KarlK90/DZZY/cross_pattern.png

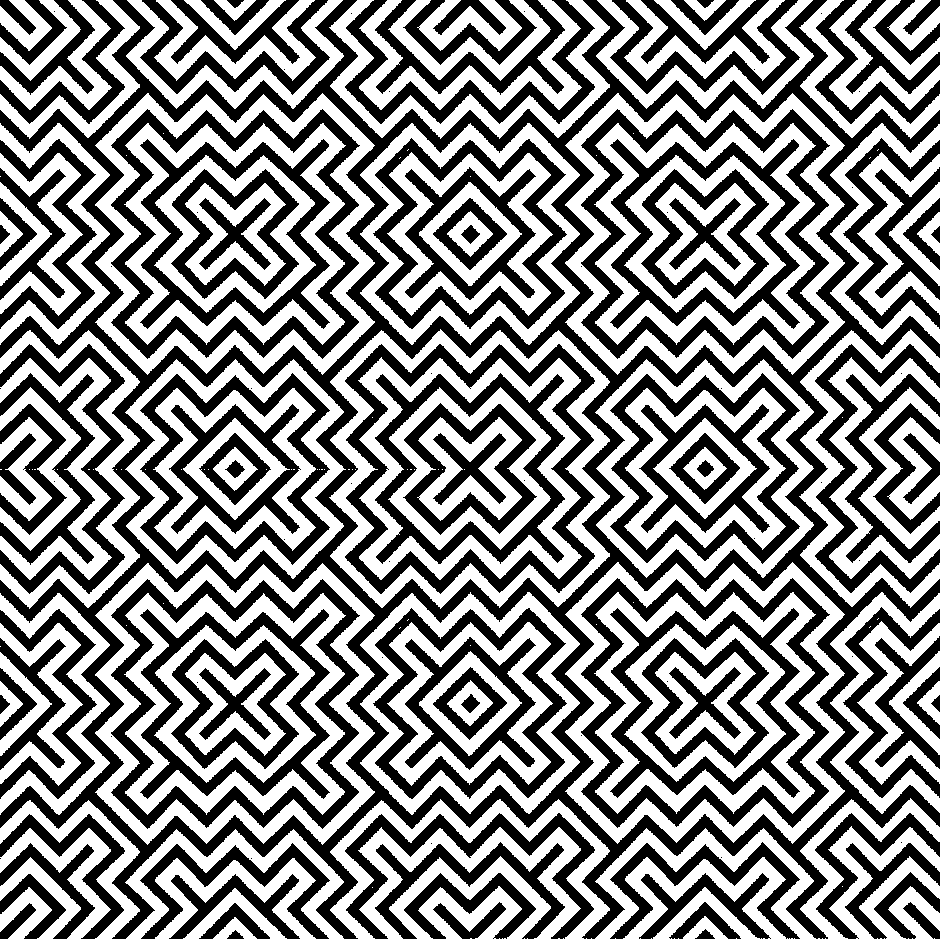
cross_pattern.png
