KarlK90/DZZY/dzzy.kicad_pcb

## KiCad design dzzy.kicad_pcb (2021-05-22)

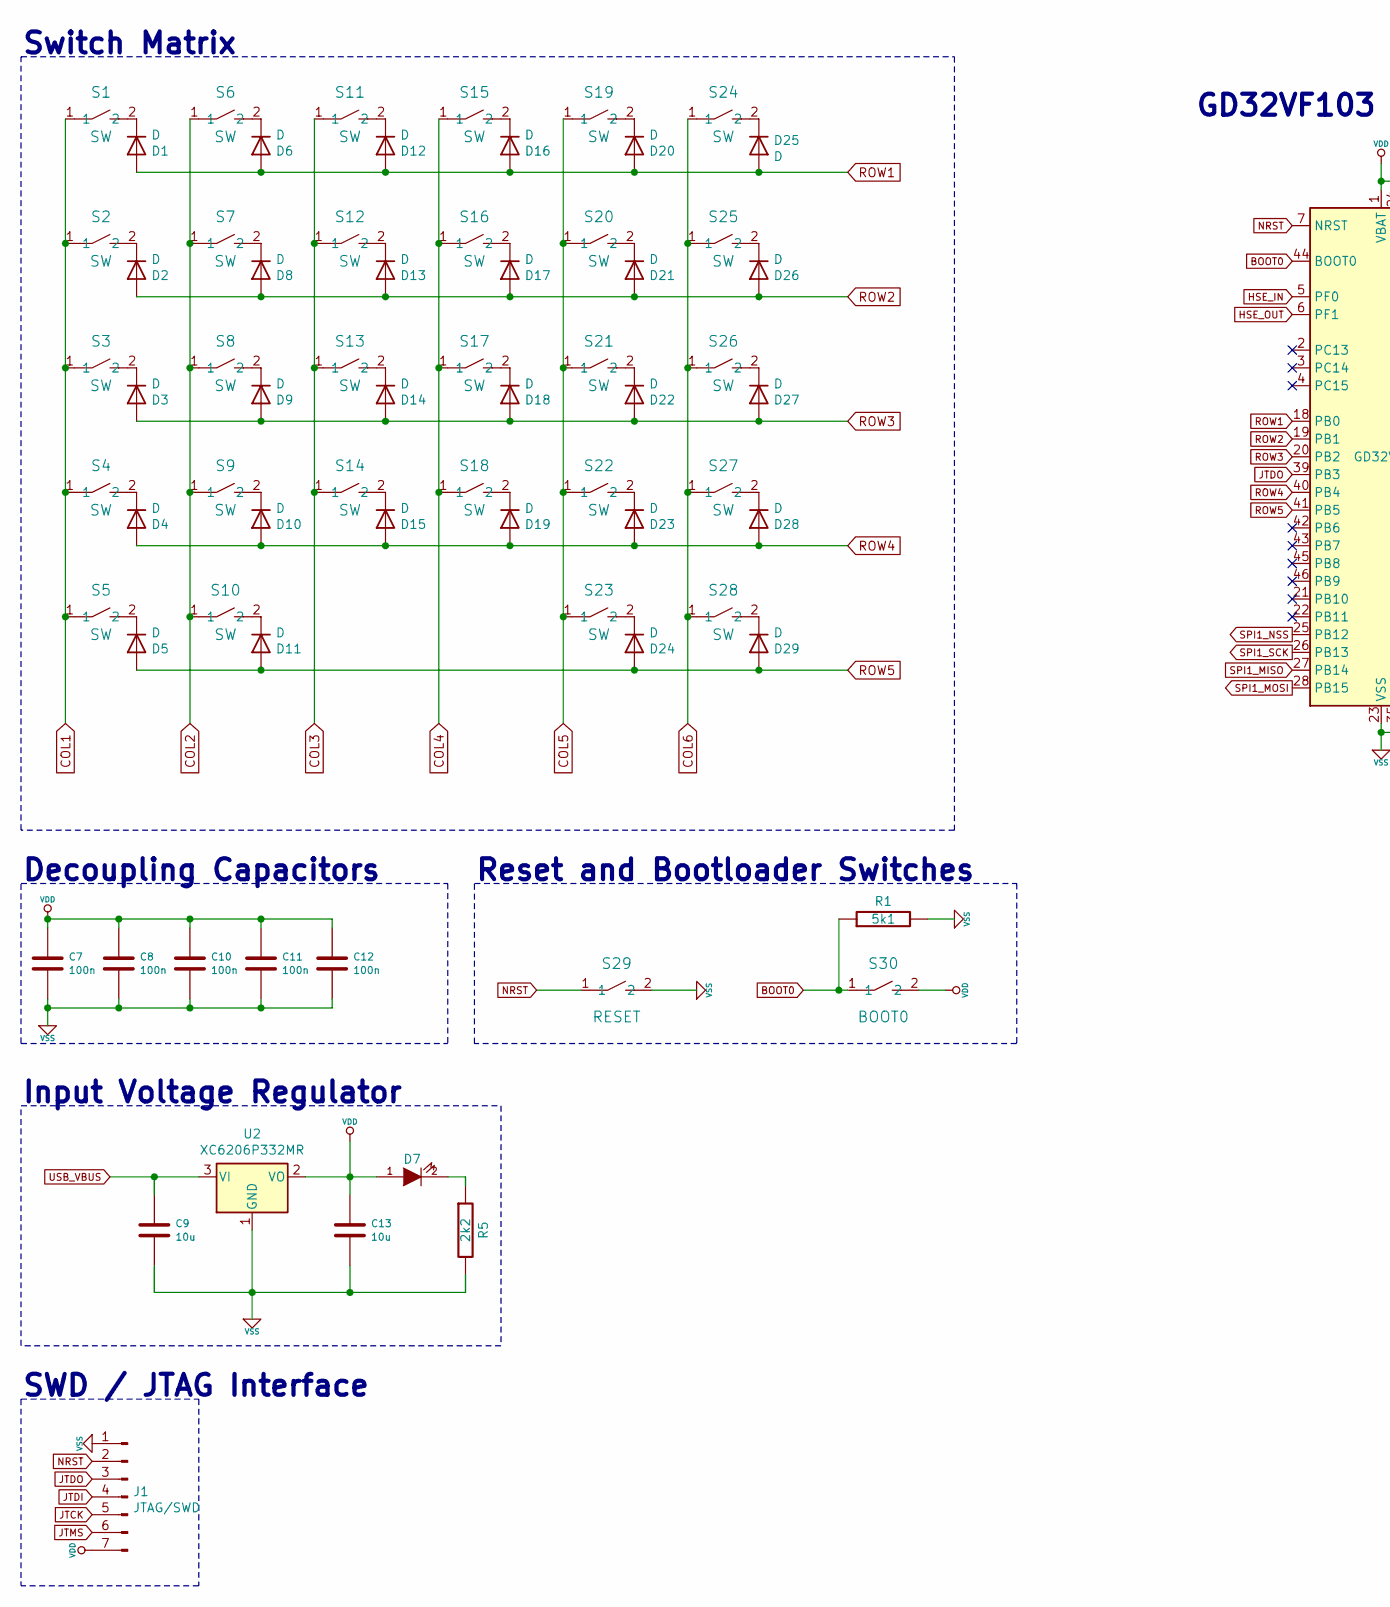
[picture p2: schematic dzzy.kicad_sch, part in row 1, column 1]

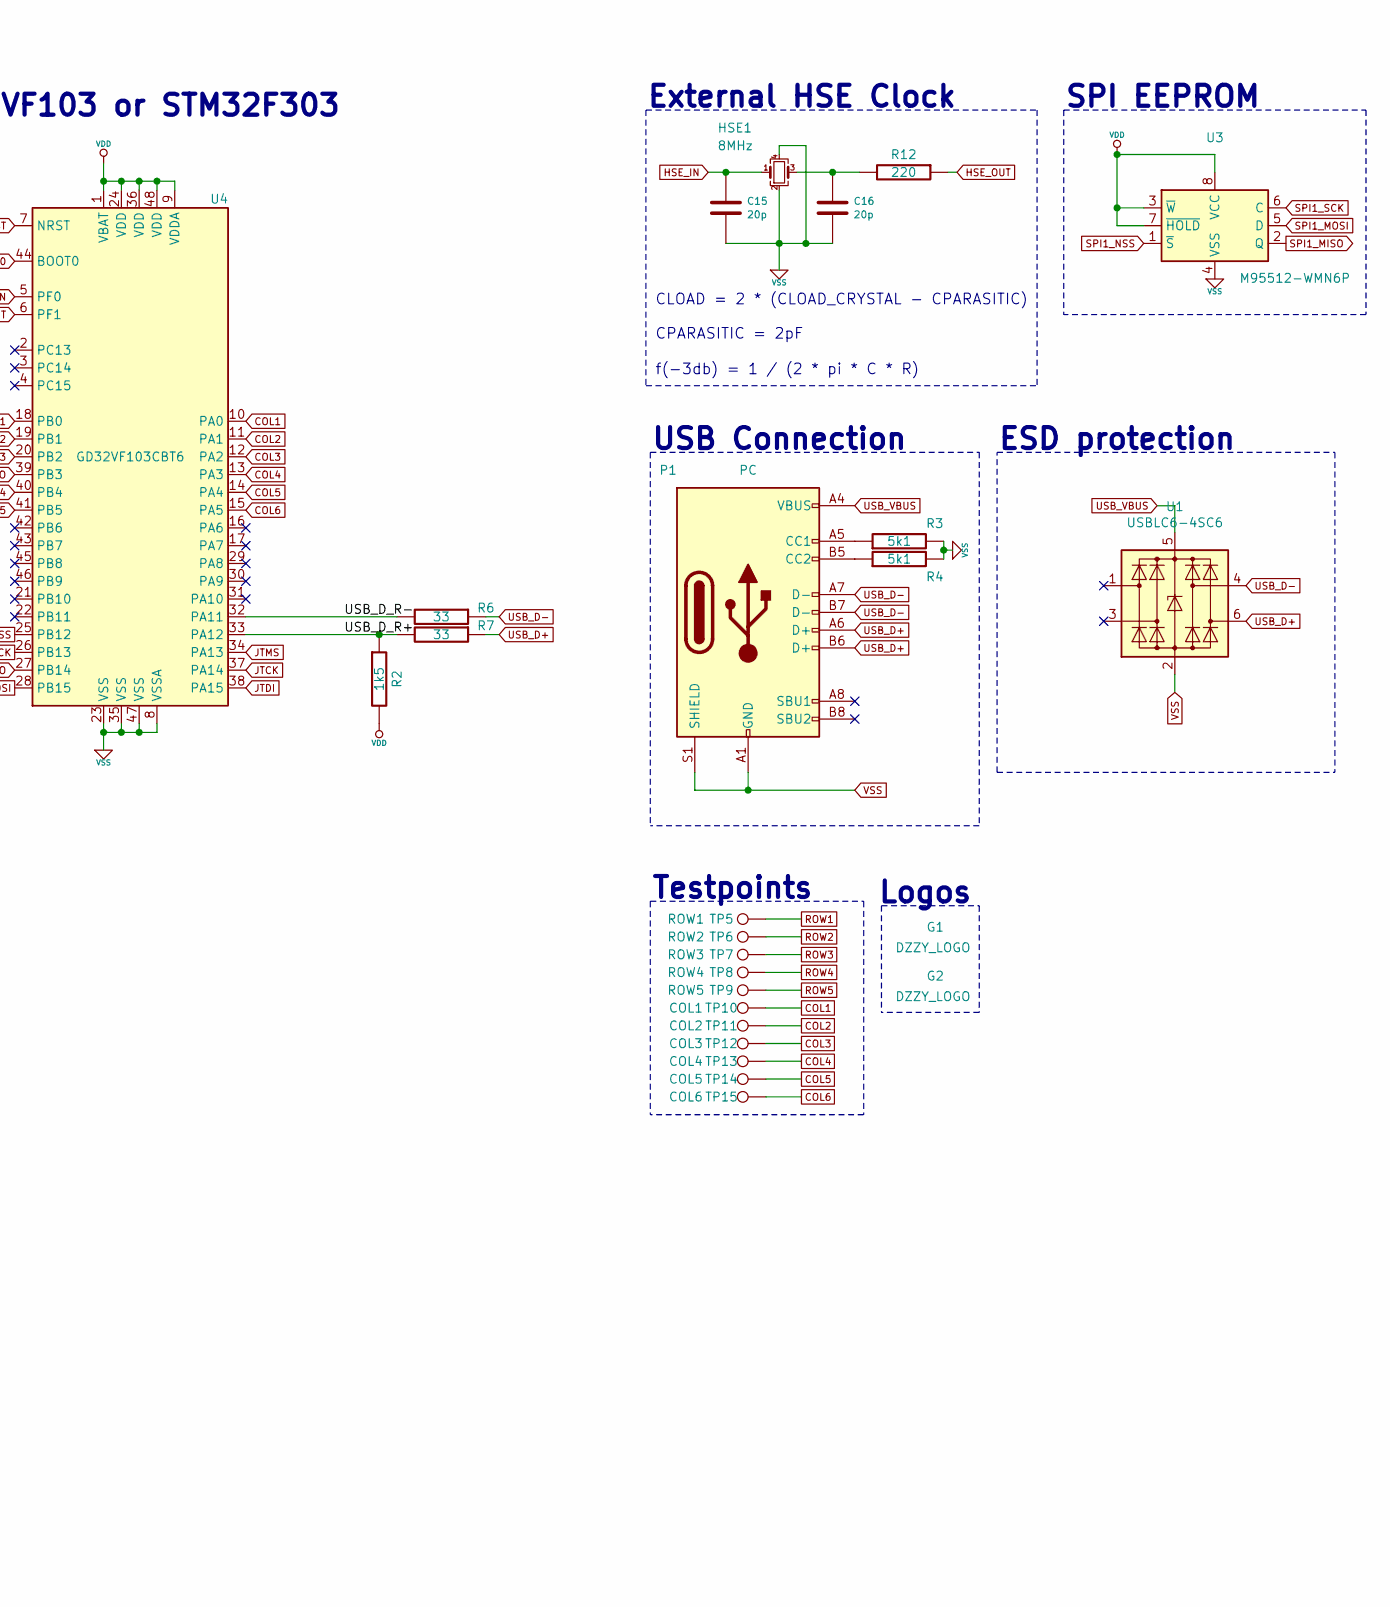
[picture p3: schematic dzzy.kicad_sch, part in row 1, column 2]

Parts:
C7, C8, C10, C11, C12: 100n; SMD-0603; LCSC Part C14663
C9, C13: 10u; SMD-0603; LCSC Part C19702
C15, C16: 20p; SMD-0603; LCSC Part C1648
D1, D2, D3, D4, D5, D6, D8, D9, D10, D11, D12, D13, D14, D15, D16, D17, D18, D19, D20, D21, D22, D23, D24, D25, D26, D27, D28, D29: D; D_SOD-123; LCSC Part C81598
D7: LED; LED-0603_flipable; LCSC Part C72041
G1, G2: DZZY_LOGO; dzzy_logo
HSE1: 8MHz; Crystal_SMD_3225-4Pin_3.2x2.5mm; LCSC Part C403948
J1: JTAG/SWD; Debug_Header_1x07_P2.54mm_Vertical
P1: PC; HRO-TYPE-C-31-M-12-HandSoldering-NoSBU; LCSC Part C168688
R1, R3, R4: 5k1; SMD-0603; LCSC Part C23186
R2: 1k5; SMD-0603; LCSC Part C22843
R5: 2k2; SMD-0603; LCSC Part C4190
R6, R7: 33; SMD-0603; LCSC Part C23140
R12: 220; SMD-0603; LCSC Part C22962
S1, S2, S3, S4, S5, S6, S7, S8, S9, S10, S15, S16, S17, S18, S19, S20, S21, S22, S23, S24, S25, S26, S27, S28: SW; SW_PG1350_reversible; JLCPCB BOM 0
S11, S12, S13, S14: SW; SW_PG1350_0.5u_stagger_reversible; JLCPCB BOM 0
S29: RESET; SW_SPST_TS_1088; LCSC Part C720478
S30: BOOT0; SW_SPST_TS_1088; LCSC Part C720478
TP5: ROW1; TestPoint
TP6: ROW2; TestPoint
TP7: ROW3; TestPoint
TP8: ROW4; TestPoint
TP9: ROW5; TestPoint
TP10: COL1; TestPoint
TP11: COL2; TestPoint
TP12: COL3; TestPoint
TP13: COL4; TestPoint
TP14: COL5; TestPoint
TP15: COL6; TestPoint
U1: USBLC6-4SC6; SOT-23-6_flipable
U2: XC6206P332MR; SOT-23; LCSC Part C5446
U3: M95512-WMN6P; SOIC-8; LCSC Part C7567
U4: GD32VF103CBT6; LQFP-48_7x7mm_P0.5mm; LCSC Part C81523

Connections:
/USB_D_R+: R2.1, R7.2, U4.33 (PA12)
/USB_D_R-: R6.2, U4.32 (PA11)
BOOT0: R1.1, S30.1, U4.44 (BOOT0)
COL1: S1.1, S2.1, S3.1, S4.1, S5.1, TP10.1, U4.10 (PA0)
COL2: S6.1, S7.1, S8.1, S9.1, S10.1, TP11.1, U4.11 (PA1)
COL3: S11.1, S12.1, S13.1, S14.1, TP12.1, U4.12 (PA2)
COL4: S15.1, S16.1, S17.1, S18.1, TP13.1, U4.13 (PA3)
COL5: S19.1, S20.1, S21.1, S22.1, S23.1, TP14.1, U4.14 (PA4)
COL6: S24.1, S25.1, S26.1, S27.1, S28.1, TP15.1, U4.15 (PA5)
HSE_IN: C15.1, HSE1.1, U4.5 (PF0)
HSE_OUT: R12.1, U4.6 (PF1)
JTCK: J1.5, U4.37 (PA14)
JTDI: J1.4, U4.38 (PA15)
JTDO: J1.3, U4.39 (PB3)
JTMS: J1.6, U4.34 (PA13)
NRST: J1.2, S29.1, U4.7 (NRST)
unnamed: C16.1, HSE1.3, R12.2
unnamed: D1.1 (K), S1.2
unnamed: D2.1 (K), S2.2
unnamed: D3.1 (K), S3.2
unnamed: D4.1 (K), S4.2
unnamed: D5.1 (K), S5.2
unnamed: D6.1 (K), S6.2
unnamed: D7.2 (K), R5.1
unnamed: D8.1 (K), S7.2
unnamed: D9.1 (K), S8.2
unnamed: D10.1 (K), S9.2
unnamed: D11.1 (K), S10.2
unnamed: D12.1 (K), S11.2
unnamed: D13.1 (K), S12.2
unnamed: D14.1 (K), S13.2
unnamed: D15.1 (K), S14.2
unnamed: D16.1 (K), S15.2
unnamed: D17.1 (K), S16.2
unnamed: D18.1 (K), S17.2
unnamed: D19.1 (K), S18.2
unnamed: D20.1 (K), S19.2
unnamed: D21.1 (K), S20.2
unnamed: D22.1 (K), S21.2
unnamed: D23.1 (K), S22.2
unnamed: D24.1 (K), S23.2
unnamed: D25.1 (K), S24.2
unnamed: D26.1 (K), S25.2
unnamed: D27.1 (K), S26.2
unnamed: D28.1 (K), S27.2
unnamed: D29.1 (K), S28.2
unnamed: P1.A5 (CC1), R3.1
unnamed: P1.B5 (CC2), R4.1
ROW1: D1.2 (A), D6.2 (A), D12.2 (A), D16.2 (A), D20.2 (A), D25.2 (A), TP5.1, U4.18 (PB0)
ROW2: D2.2 (A), D8.2 (A), D13.2 (A), D17.2 (A), D21.2 (A), D26.2 (A), TP6.1, U4.19 (PB1)
ROW3: D3.2 (A), D9.2 (A), D14.2 (A), D18.2 (A), D22.2 (A), D27.2 (A), TP7.1, U4.20 (PB2)
ROW4: D4.2 (A), D10.2 (A), D15.2 (A), D19.2 (A), D23.2 (A), D28.2 (A), TP8.1, U4.40 (PB4)
ROW5: D5.2 (A), D11.2 (A), D24.2 (A), D29.2 (A), TP9.1, U4.41 (PB5)
SPI1_MISO: U3.2 (Q), U4.27 (PB14)
SPI1_MOSI: U3.5 (D), U4.28 (PB15)
SPI1_NSS: U3.1 (~S), U4.25 (PB12)
SPI1_SCK: U3.6 (C), U4.26 (PB13)
USB_D+: P1.A6 (D+), P1.B6 (D+), R7.1, U1.6 (I/O4)
USB_D-: P1.A7 (D-), P1.B7 (D-), R6.1, U1.4 (I/O3)
USB_VBUS: C9.1, P1.A4 (VBUS), P1.A9 (VBUS), P1.B4 (VBUS), P1.B9 (VBUS), U1.5 (VBUS), U2.3 (VI)
VDD: C7.1, C8.1, C10.1, C11.1, C12.1, C13.1, D7.1 (A), J1.7, R2.2, S30.2, U2.2 (VO), U3.3 (~W), U3.7 (~HOLD), U3.8 (VCC), U4.1 (VBAT), U4.9 (VDDA), U4.24 (VDD), U4.36 (VDD), U4.48 (VDD)
VSS: C7.2, C8.2, C9.2, C10.2, C11.2, C12.2, C13.2, C15.2, C16.2, HSE1.2, HSE1.4, J1.1, P1.A1 (GND), P1.A12 (GND), P1.B1 (GND), P1.B12 (GND), P1.S1 (SHIELD), R1.2, R3.2, R4.2, R5.2, S29.2, U1.2 (GND), U2.1 (GND), U3.4 (VSS), U4.8 (VSSA), U4.23 (VSS), U4.35 (VSS), U4.47 (VSS)

Notes on the sheet:
Switch Matrix
Decoupling Capacitors
Input Voltage Regulator
SWD / JTAG Interface
Reset and Bootloader Switches
GD32VF103 or STM32F303
External HSE Clock
USB Connection
Testpoints
CLOAD = 2 * (CLOAD_CRYSTAL - CPARASITIC) CPARASITIC = 2pF
f(-3db) = 1 / (2 * pi * C * R)
Logos
ESD protection
SPI EEPROM

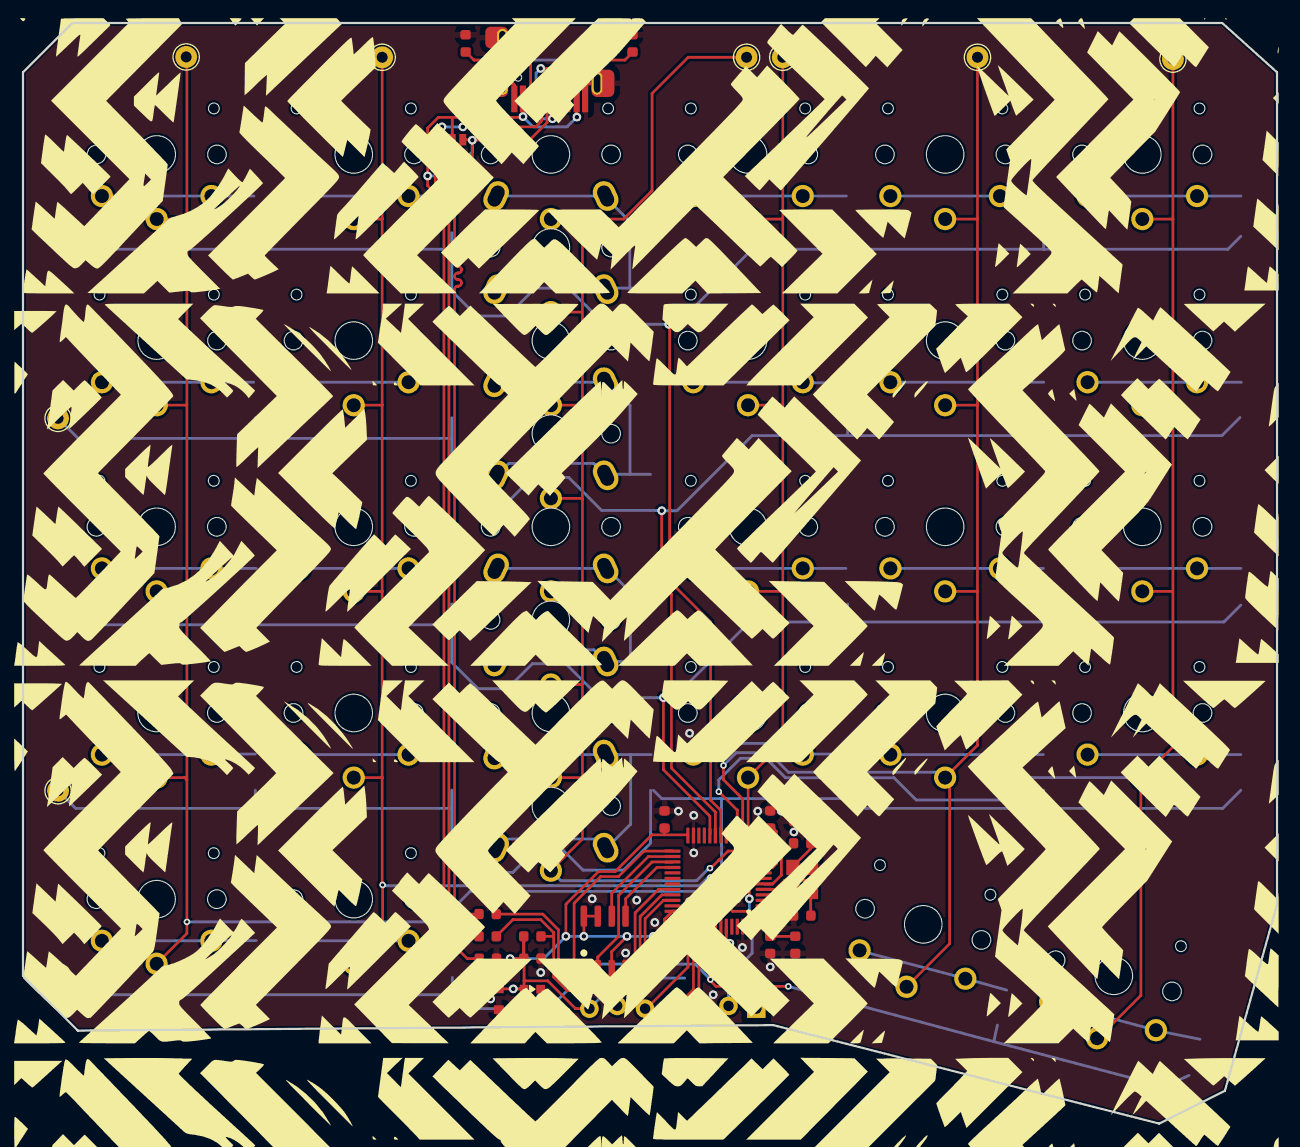
[picture p4: board dzzy.kicad_pcb from above]

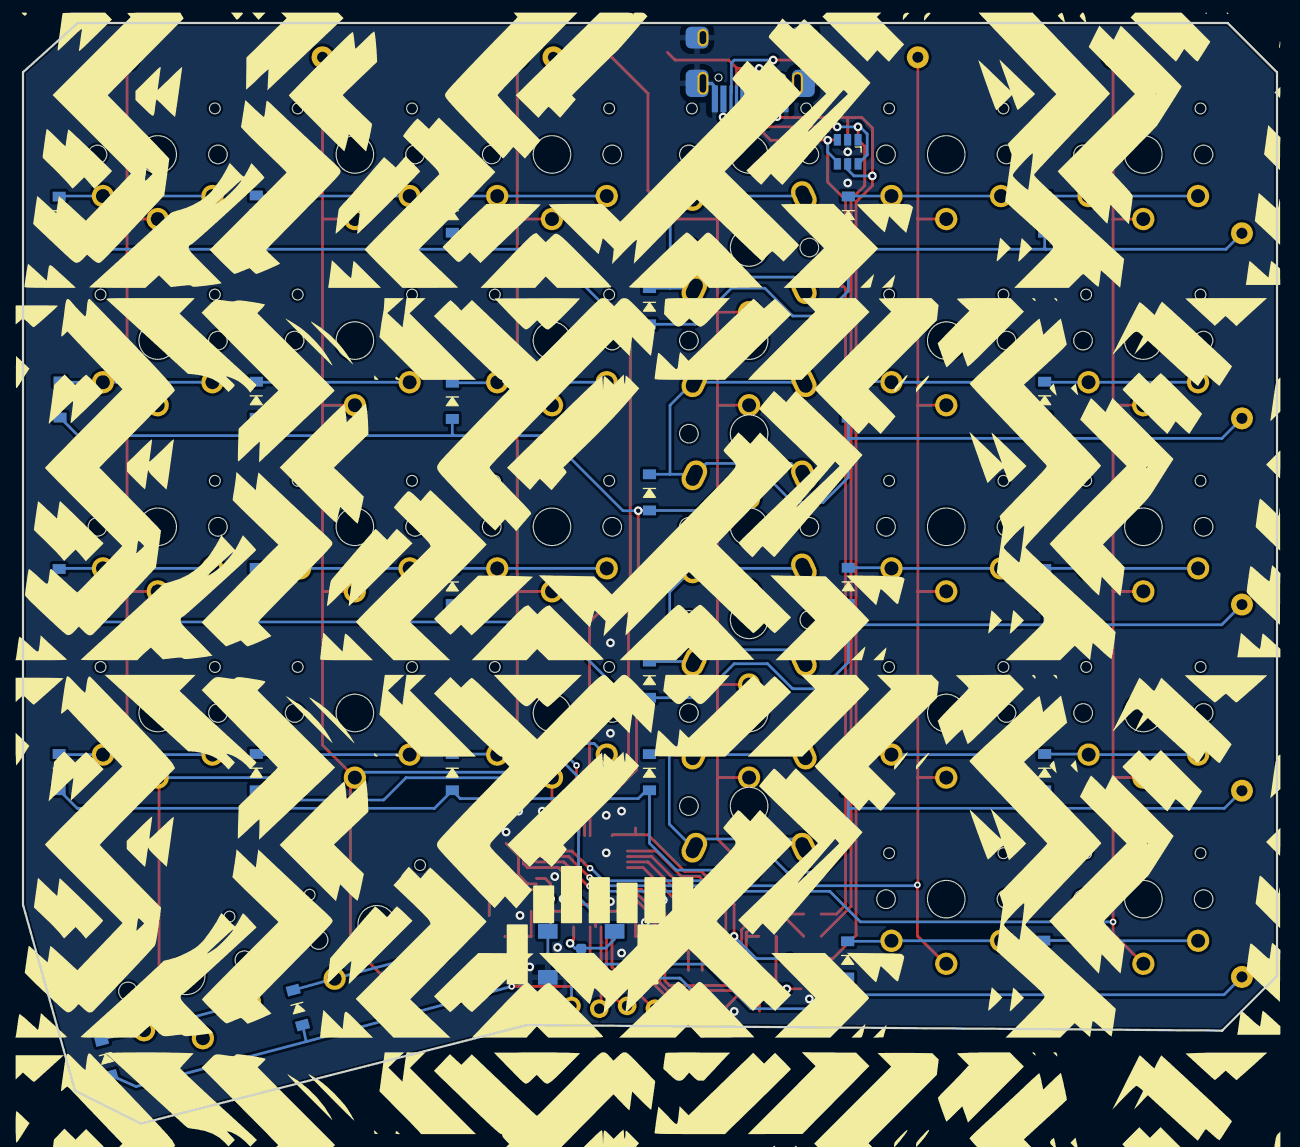
[picture p5: board dzzy.kicad_pcb from below]

Board: 2 copper layers, 114.5 x 100.5 mm, 96 parts (32 on the bottom side), 62 nets.
