KarlK90/DZZY/(commit log)

2021-05-21 Add DZZY Rev.1
    [dzzy-B_Cu.gbr, dzzy-B_Mask.gbr, dzzy-B_Paste.gbr, dzzy-B_Silkscreen.gbr, dzzy-Edge_Cuts.gbr, dzzy-F_Cu.gbr, dzzy-F_Mask.gbr, dzzy-F_Paste.gbr]
2021-05-22 Update ESD diode placement and silkscreen
    [dzzy-B_Cu.gbr, dzzy-B_Mask.gbr, dzzy-B_Paste.gbr, dzzy-B_Silkscreen.gbr, dzzy-Edge_Cuts.gbr, dzzy-F_Cu.gbr, dzzy-F_Mask.gbr, dzzy-F_Paste.gbr]
